NAZRULHAKIM03/smart-energy-meter/docs/backend_flowchart.png

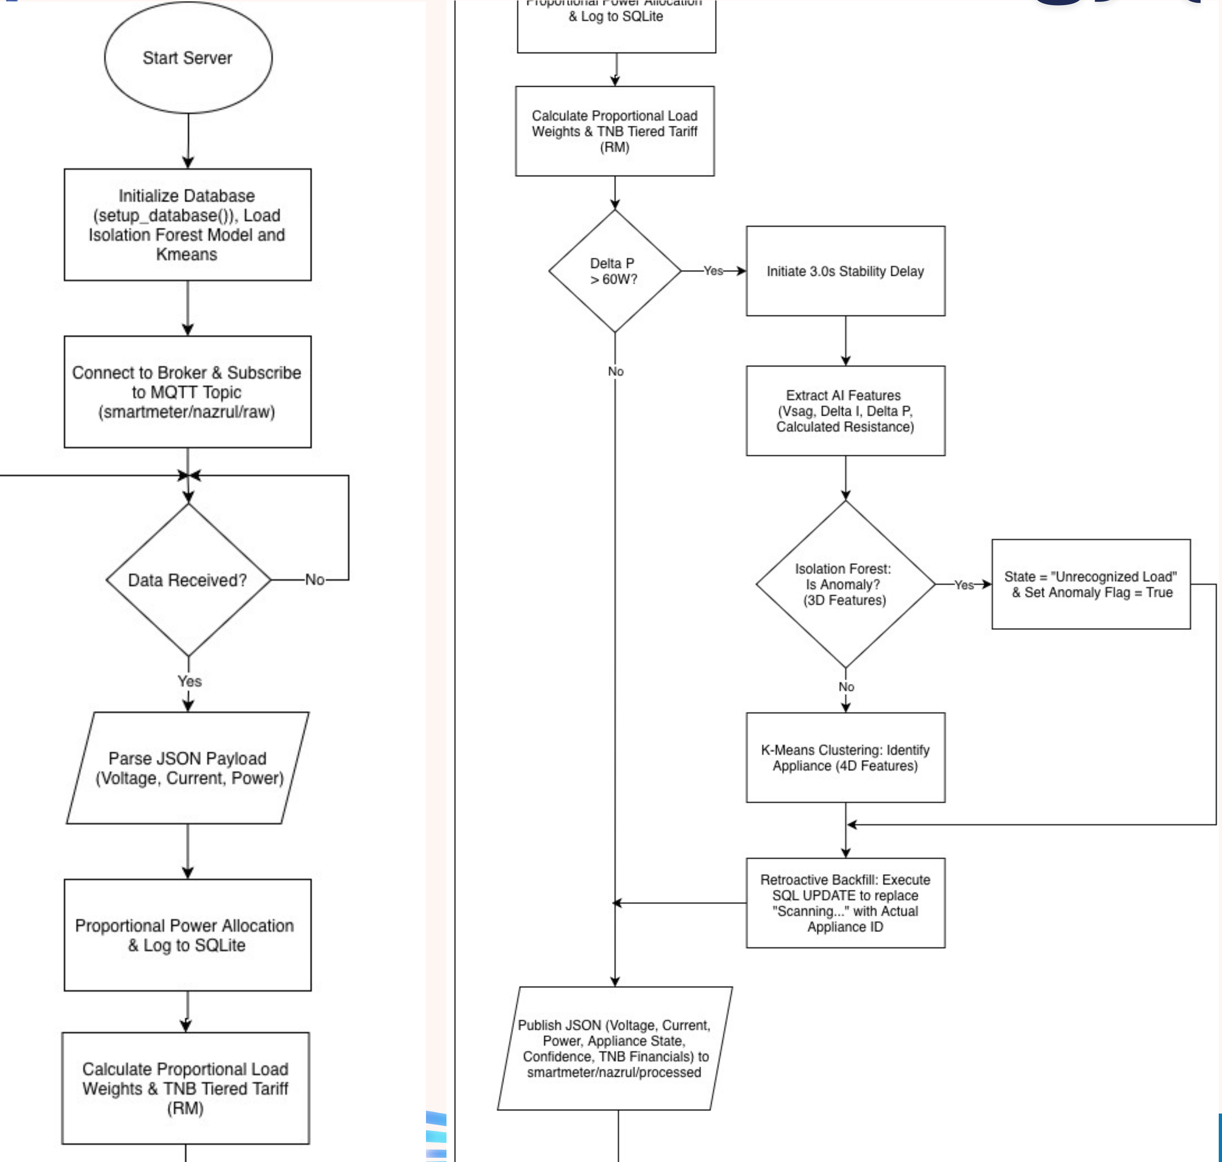
docs/backend_flowchart.png
