NAZRULHAKIM03/smart-energy-meter/docs/firmware_flowchart.png

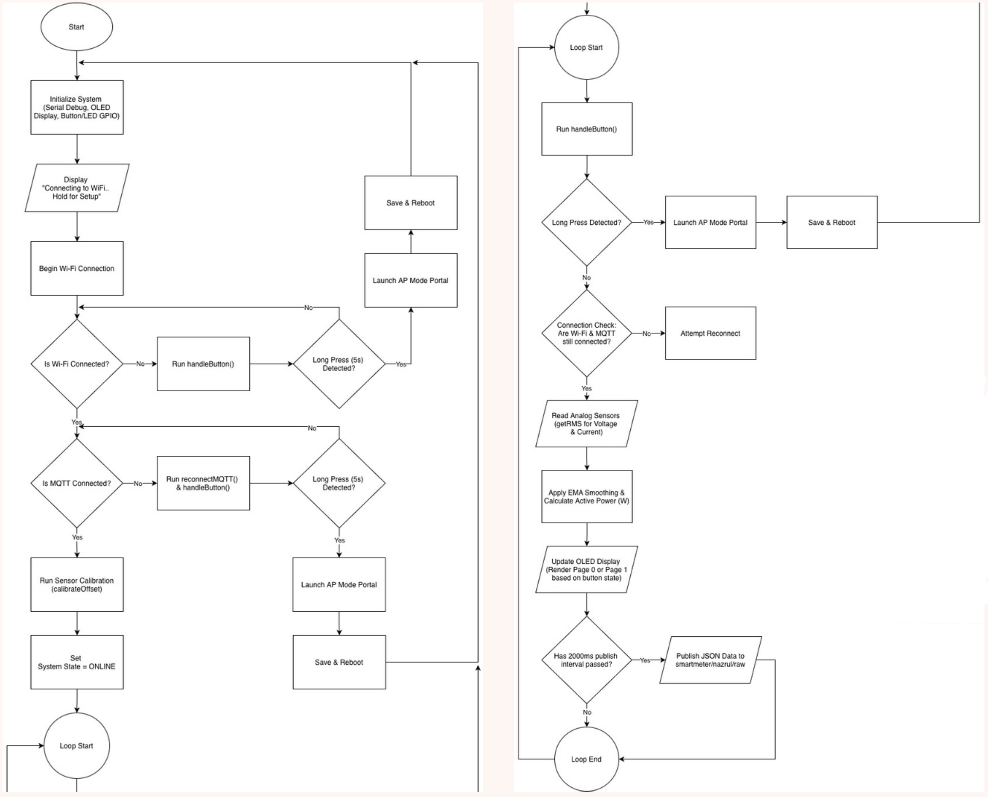
docs/firmware_flowchart.png
