NAZRULHAKIM03/smart-energy-meter/docs/images/prototype1.png

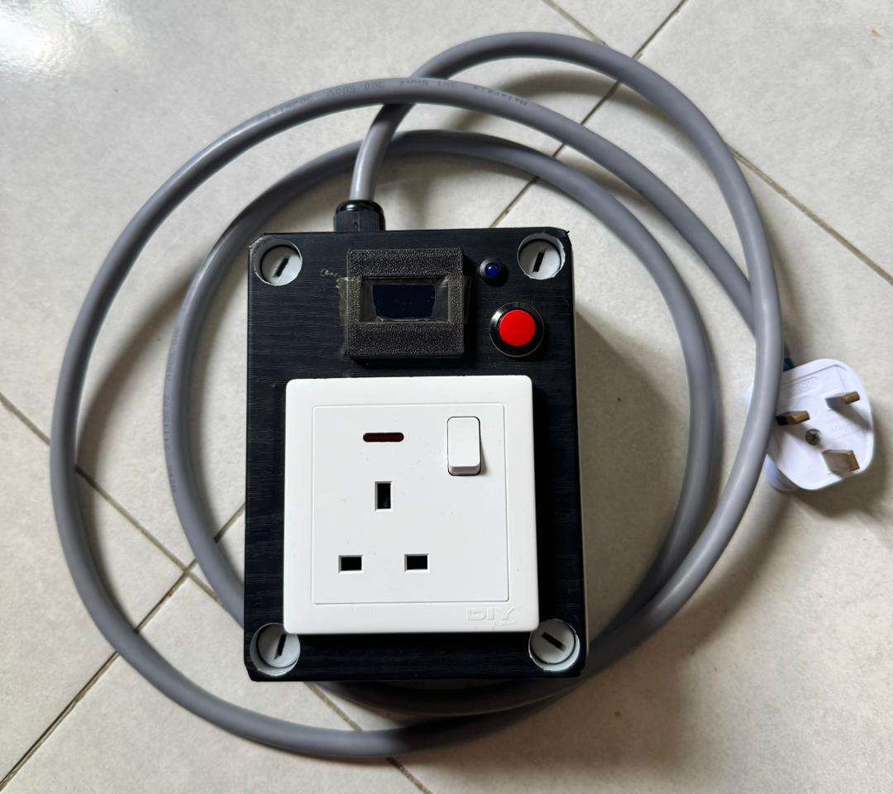
docs/images/prototype1.png
