NAZRULHAKIM03/smart-energy-meter/docs/sample_audit_pdf_report.png

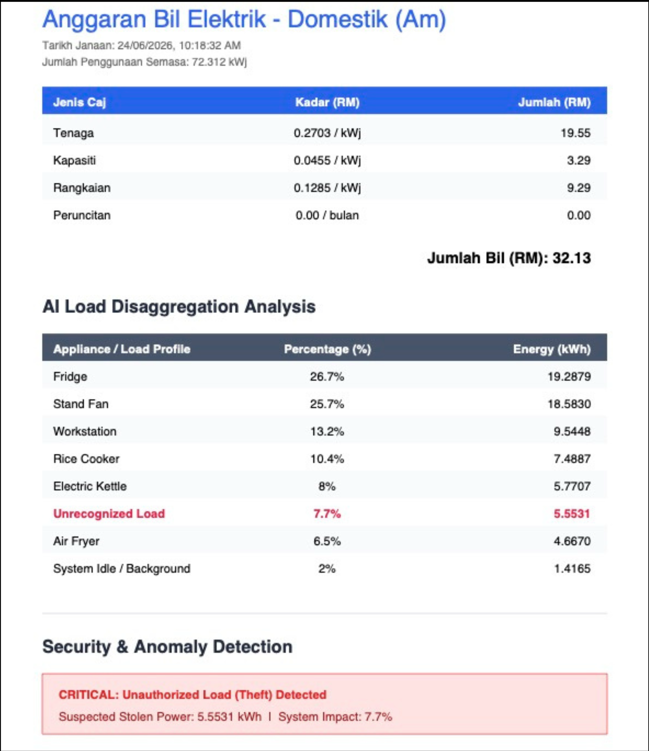
docs/sample_audit_pdf_report.png
