NAZRULHAKIM03/smart-energy-meter/(commit log)

2026-11-08 Add ESP32 firmware
2026-11-08 Add block diagram, schematic, prototype and result images
2026-11-08 Add flowcharts and sample audit report
2026-11-09 Update prototype image in README.md
2026-11-10 Make correction on the interval value in esp32_firmware.ino
    [esp32_firmware.ino]
